loidolt/mostly-printed-cnc/README.md

# Mostly Printed CNC

Config and parts for the mostly printed cnc.

## Contributing
Pull requests are welcome. For major changes, please open an issue first to discuss what you would like to change.

Please make sure to update tests as appropriate.
