loidolt/mostly-printed-cnc/ModParts/Dewalt DW660 Mount/660_lower_main.stl

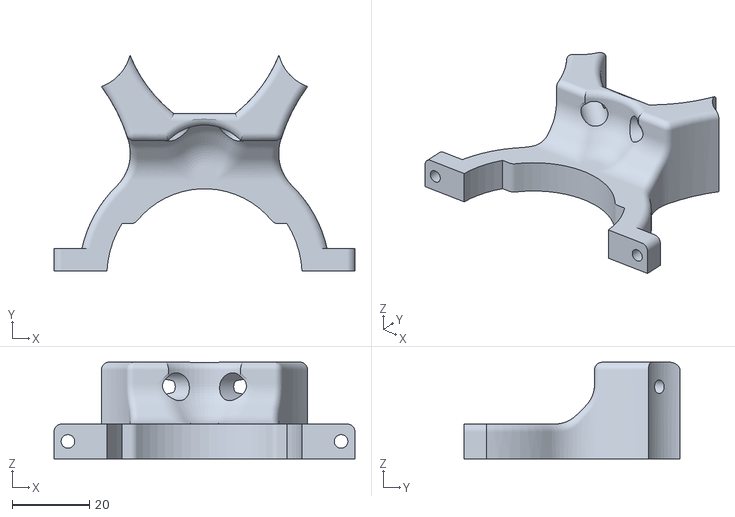
[picture p1: CAD file, 2019-04-01]
ModParts/Dewalt DW660 Mount/660_lower_main.stl
77.9 x 55.8 x 25.0
