loidolt/mostly-printed-cnc/ModParts/Dewalt DW660 Mount/660_upper_main.stl

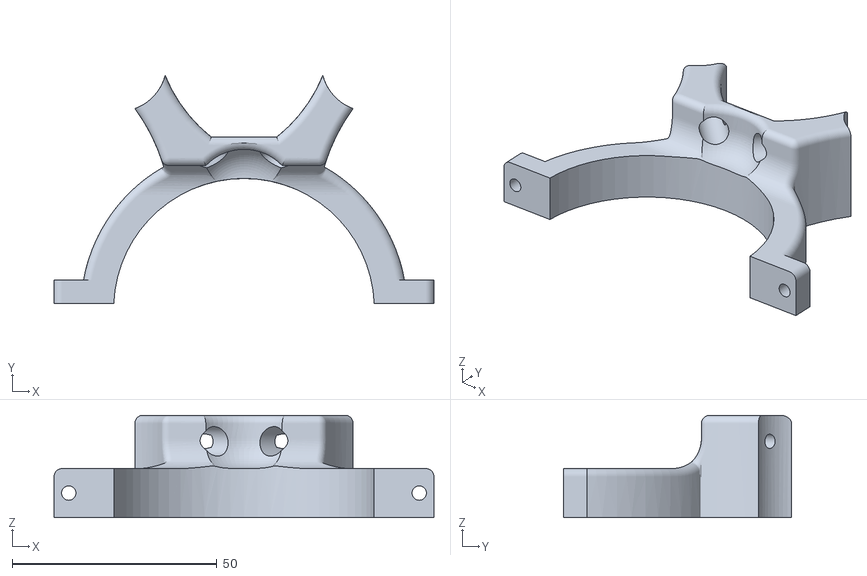
[picture p2: CAD file, 2019-04-01]
ModParts/Dewalt DW660 Mount/660_upper_main.stl
92.9 x 55.8 x 25.0
