loidolt/mostly-printed-cnc/Calibration/clampingHoles.dxf

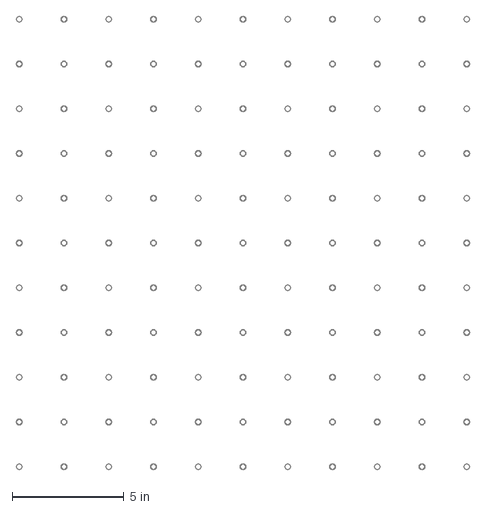
[picture p3: CAD file, 2019-04-01]
Calibration/clampingHoles.dxf
20.2 x 20.2 in
