loidolt/mostly-printed-cnc/ModParts/Cable Chain/cable_chain_plated.stl

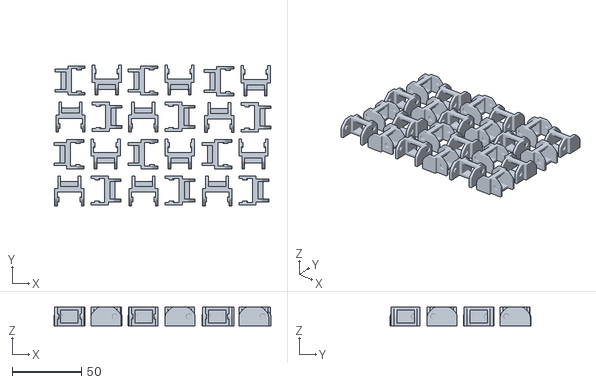
[picture p4: CAD file, 2019-04-01]
ModParts/Cable Chain/cable_chain_plated.stl
156.8 x 101.6 x 13.5
