loidolt/mostly-printed-cnc/ModParts/Drag knife/Blade_Cover.stl

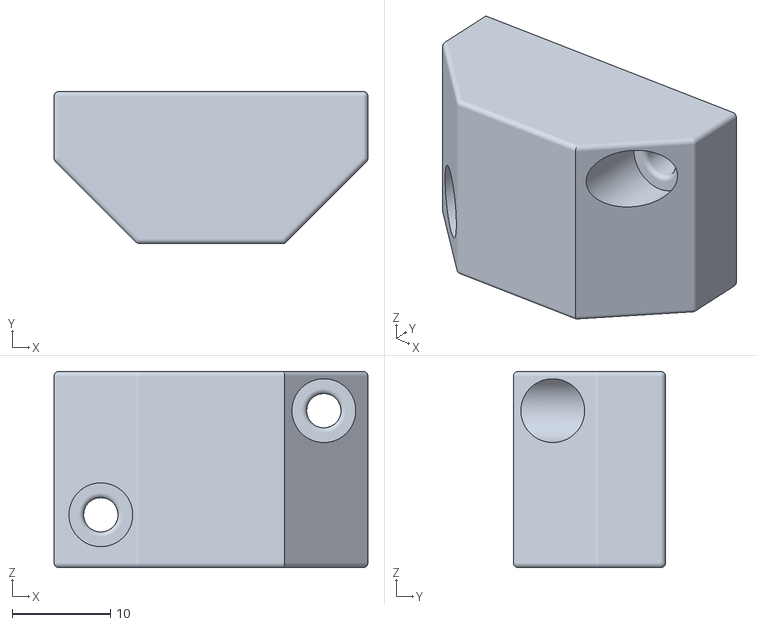
[picture p5: CAD file, 2019-04-01]
ModParts/Drag knife/Blade_Cover.stl
32.0 x 15.5 x 20.0
