loidolt/mostly-printed-cnc/ModParts/Electronics Case/standoff.stl

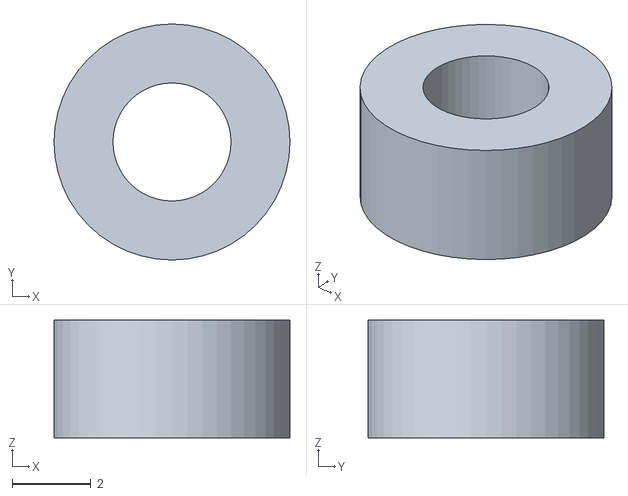
[picture p6: CAD file, 2019-04-01]
ModParts/Electronics Case/standoff.stl
6.00 x 6.00 x 3.00
