loidolt/mostly-printed-cnc/ModParts/EMT_Conduit_Caps/emtcapwireslotv2.STL

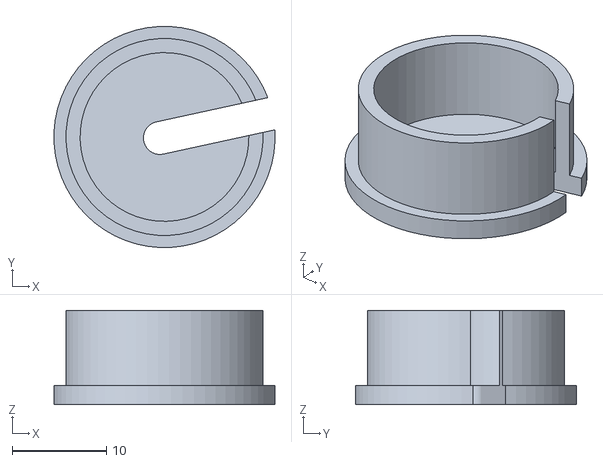
[picture p7: CAD file, 2019-04-01]
ModParts/EMT_Conduit_Caps/emtcapwireslotv2.STL
23.5 x 23.5 x 10.0
