loidolt/mostly-printed-cnc/ModParts/Feet/IE_Foot_Bottom.stl

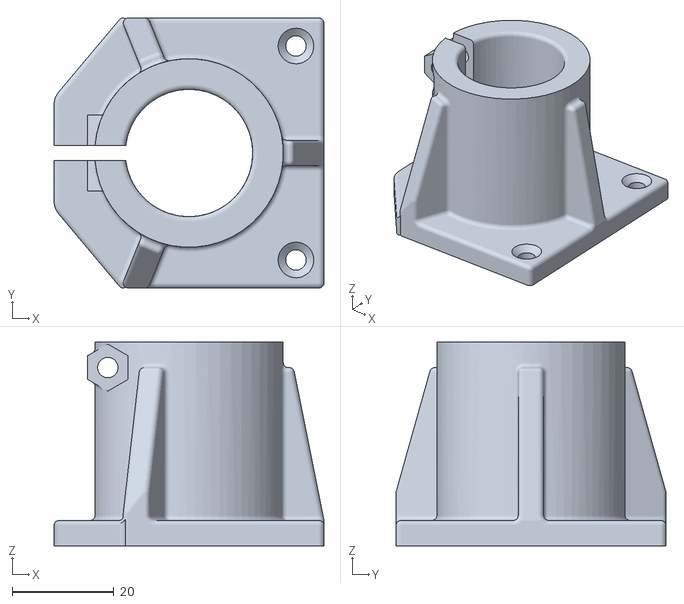
[picture p8: CAD file, 2019-04-01]
ModParts/Feet/IE_Foot_Bottom.stl
53.0 x 53.0 x 40.0
