loidolt/mostly-printed-cnc/ModParts/Modular Electronics Case/Designed/powerSwitchPanel.stl

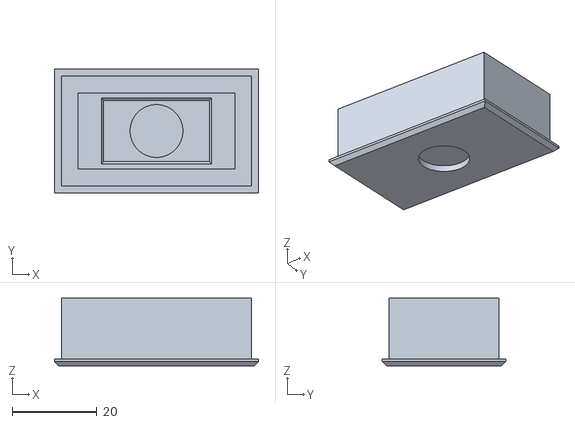
[picture p9: CAD file, 2019-04-01]
ModParts/Modular Electronics Case/Designed/powerSwitchPanel.stl
48.2 x 29.2 x 16.0
