loidolt/mostly-printed-cnc/ModParts/Modular Electronics Case/mm_ramps1dot4_pi_lower.stl

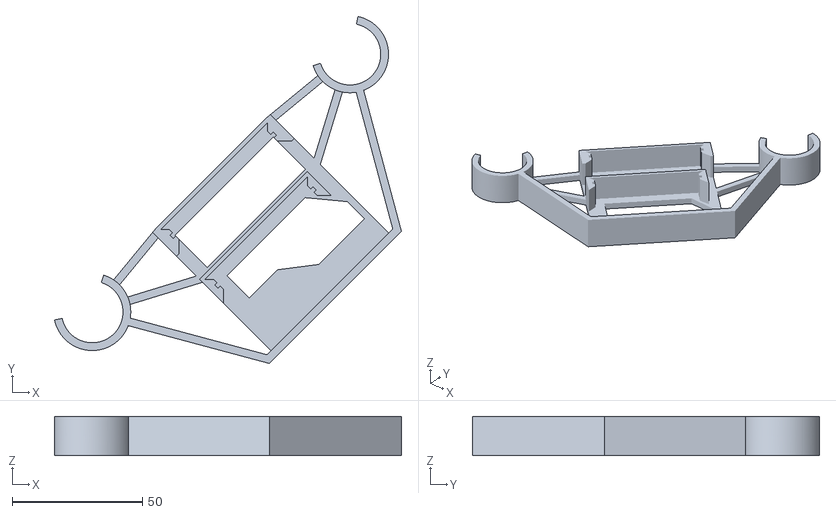
[picture p10: CAD file, 2019-04-01]
ModParts/Modular Electronics Case/mm_ramps1dot4_pi_lower.stl
133.3 x 133.3 x 15.0
