loidolt/mostly-printed-cnc/ModParts/Pen Mount/Tool_mount_insert.STL

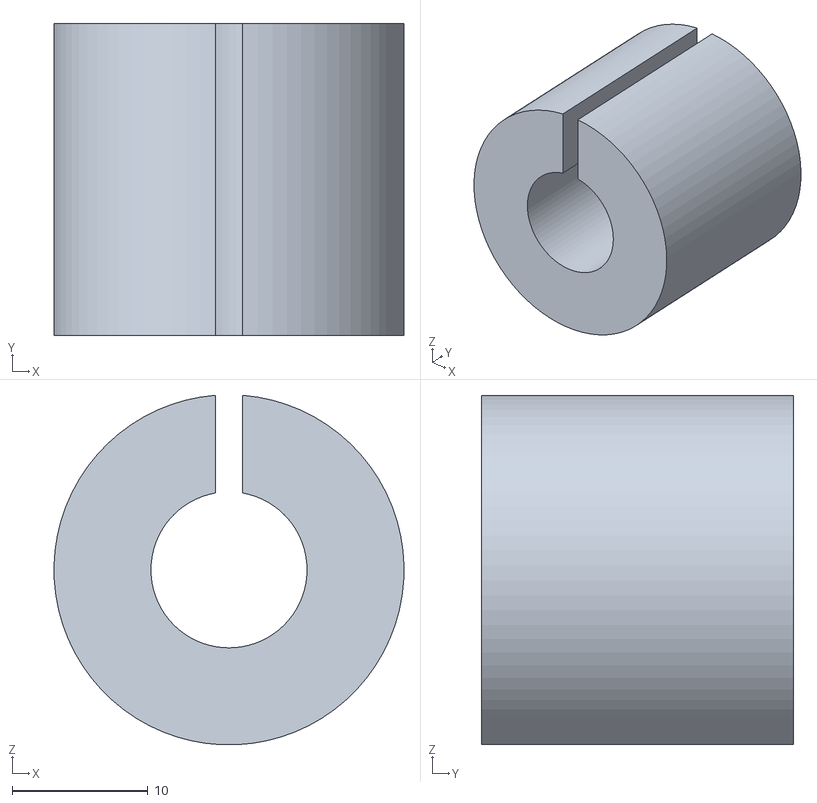
[picture p11: CAD file, 2019-04-01]
ModParts/Pen Mount/Tool_mount_insert.STL
25.8 x 23.0 x 25.7
