loidolt/mostly-printed-cnc/ModParts/RAMPs 1.4 Case/80mm_fan_adapter_case_for_arduino_mega_r3_and_ramps_14.stl

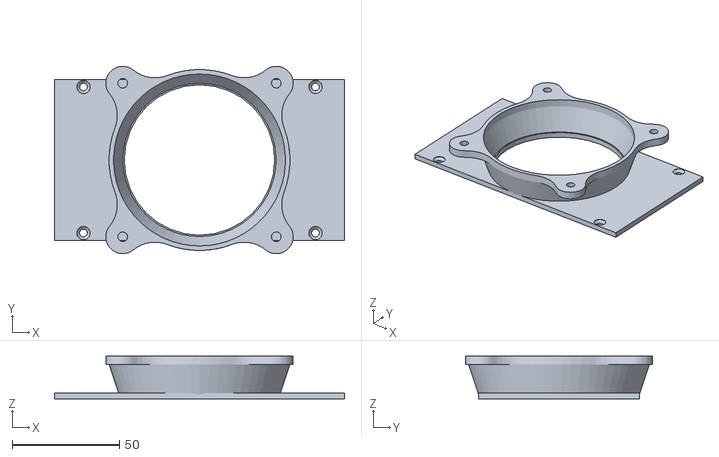
[picture p12: CAD file, 2019-04-01]
ModParts/RAMPs 1.4 Case/80mm_fan_adapter_case_for_arduino_mega_r3_and_ramps_14.stl
135.0 x 87.2 x 20.0
