loidolt/mostly-printed-cnc/ModParts/Ramps14SmartLCD/minion_body_bottom_remix_1.0.stl

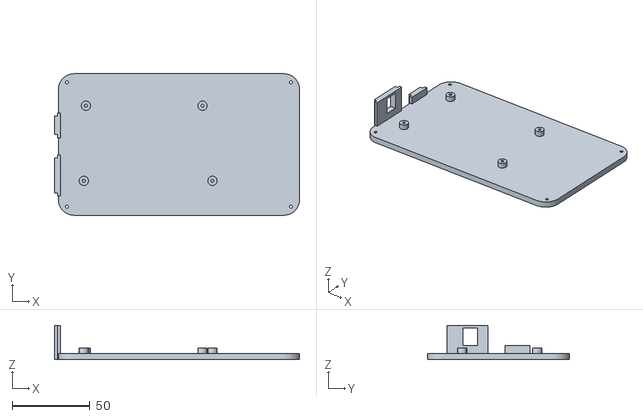
[picture p13: CAD file, 2019-04-01]
ModParts/Ramps14SmartLCD/minion_body_bottom_remix_1.0.stl
157.5 x 91.0 x 21.9
