loidolt/mostly-printed-cnc/ModParts/Sainsmart_12864_LCD_case/knob.stl

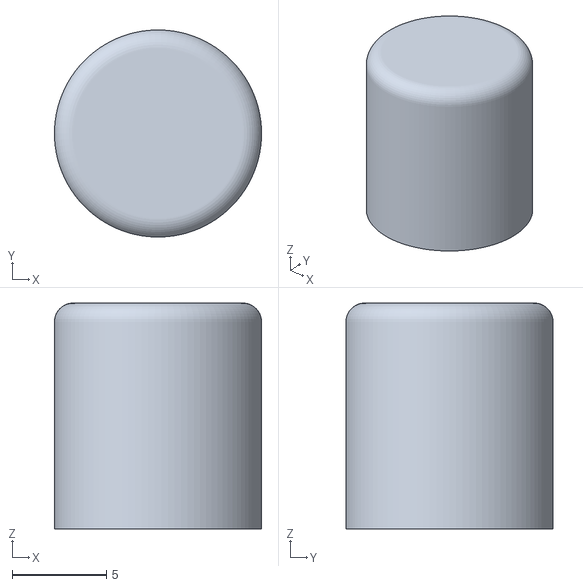
[picture p14: CAD file, 2019-04-01]
ModParts/Sainsmart_12864_LCD_case/knob.stl
11.0 x 11.0 x 12.0
