loidolt/mostly-printed-cnc/ModParts/solderless_Roller_Motor_Mount.STL

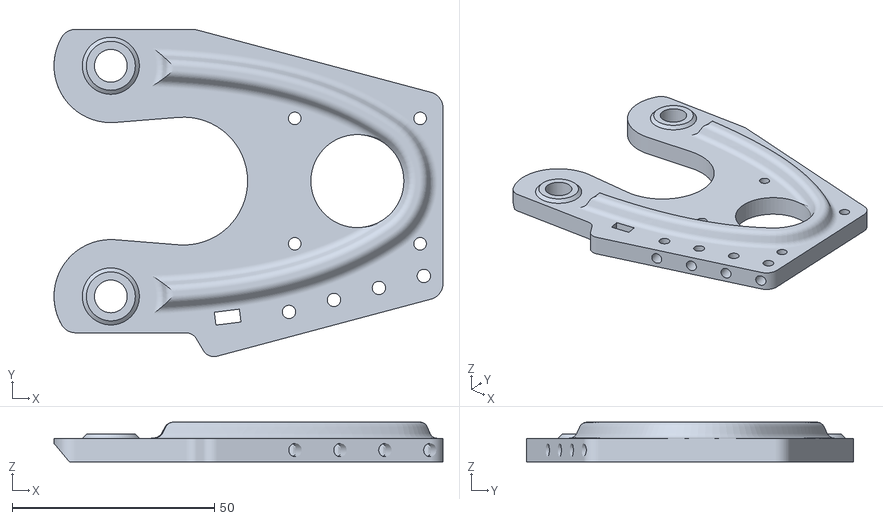
[picture p15: CAD file, 2019-04-01]
ModParts/solderless_Roller_Motor_Mount.STL
96.1 x 80.9 x 9.84
