loidolt/mostly-printed-cnc/ModParts/Square Check/MPCNC_Square_Check_Long_Side.stl

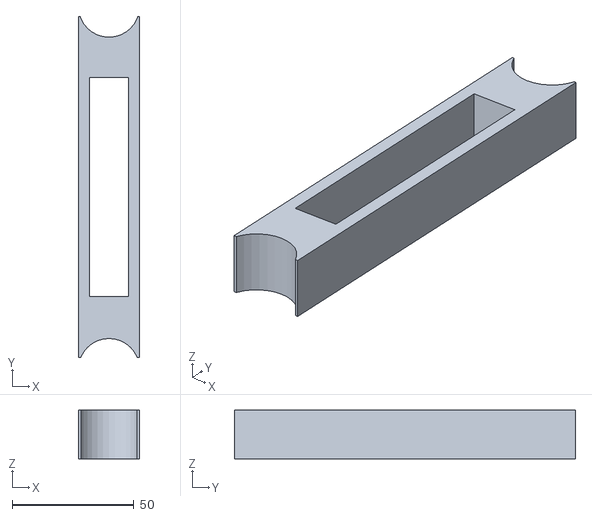
[picture p16: CAD file, 2019-04-01]
ModParts/Square Check/MPCNC_Square_Check_Long_Side.stl
25.0 x 140.0 x 20.0
