loidolt/mostly-printed-cnc/SettingsandProfiles/Marlin-Release/Documentation/Logo/Marlin Logo.dxf

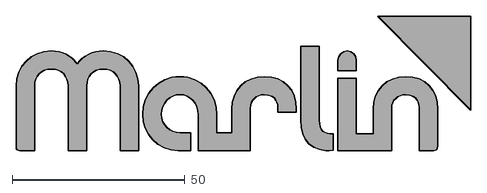
[picture p17: CAD file, 2019-04-01]
SettingsandProfiles/Marlin-Release/Documentation/Logo/Marlin Logo.dxf
131.6 x 39.5
