loidolt/mostly-printed-cnc/Calibration/ShapeOko_Calibration_Pattern_01b.dxf

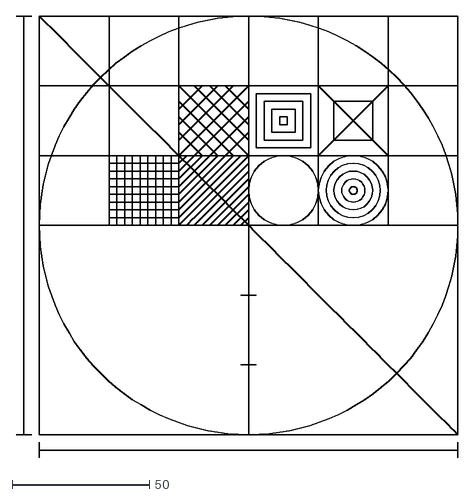
[picture p18: CAD file, 2019-04-01]
Calibration/ShapeOko_Calibration_Pattern_01b.dxf
160.9 x 160.9
