loidolt/mostly-printed-cnc/ModParts/Cable Chain/Chain_Guide_Brkt.stl

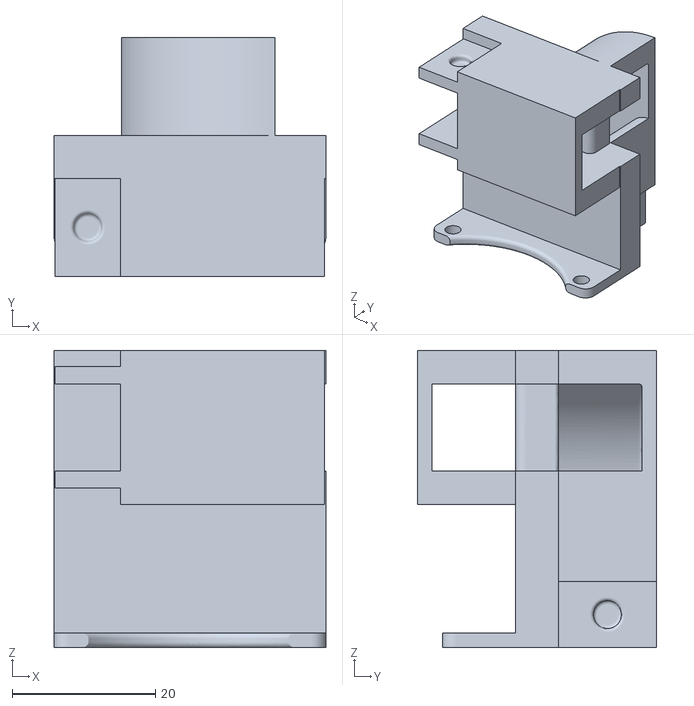
[picture p19: CAD file, 2019-04-01]
ModParts/Cable Chain/Chain_Guide_Brkt.stl
38.0 x 33.4 x 41.5
