loidolt/mostly-printed-cnc/ModParts/Dewalt DW660 Mount/660_lower_clamp.stl

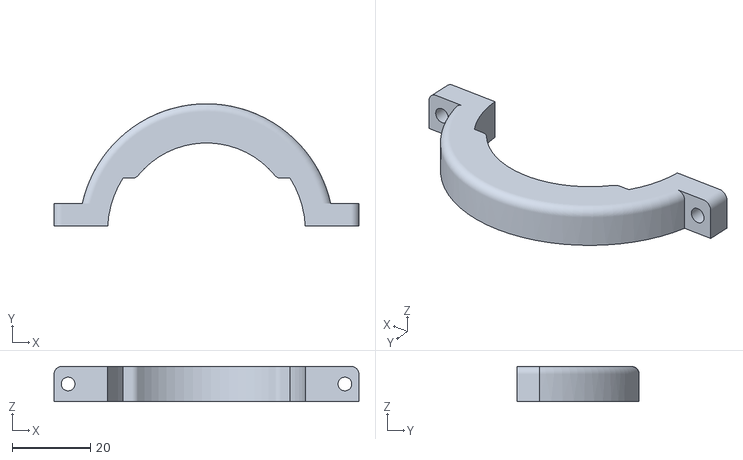
[picture p20: CAD file, 2019-04-01]
ModParts/Dewalt DW660 Mount/660_lower_clamp.stl
77.9 x 31.2 x 9.00
