loidolt/mostly-printed-cnc/ModParts/Drag knife/P3.stl

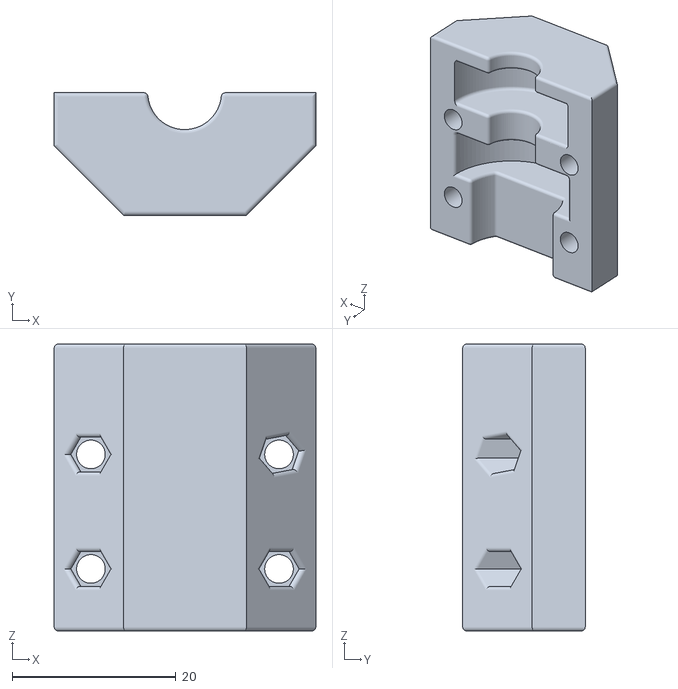
[picture p21: CAD file, 2019-04-01]
ModParts/Drag knife/P3.stl
32.0 x 15.0 x 35.1
