loidolt/mostly-printed-cnc/ModParts/Electronics Case/electronicsCaseBack.stl

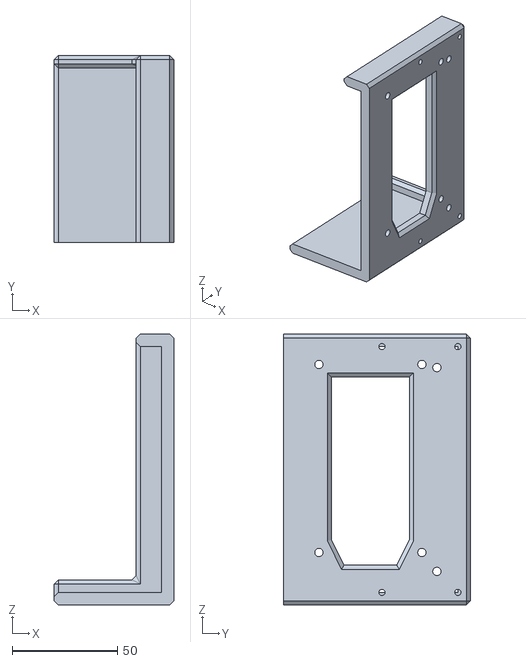
[picture p22: CAD file, 2019-04-01]
ModParts/Electronics Case/electronicsCaseBack.stl
57.0 x 89.0 x 129.0
