loidolt/mostly-printed-cnc/ModParts/EMT_Conduit_Caps/emtcapv2.STL

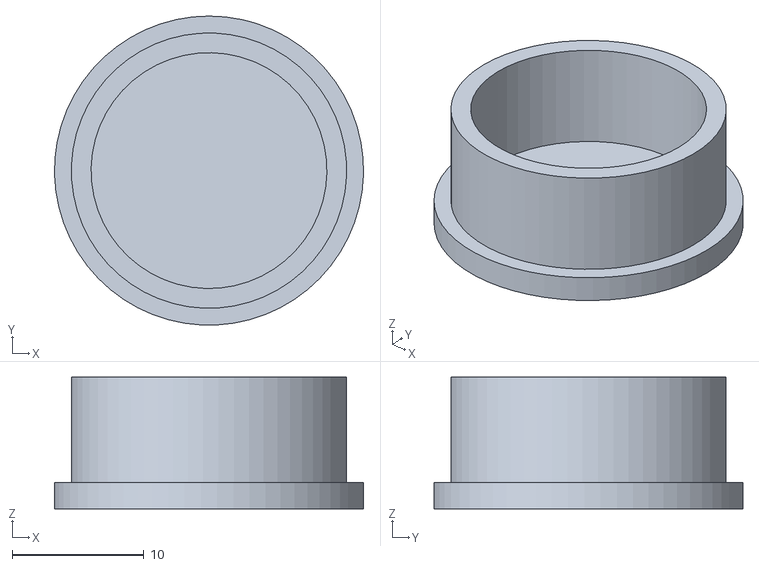
[picture p23: CAD file, 2019-04-01]
ModParts/EMT_Conduit_Caps/emtcapv2.STL
23.5 x 23.5 x 10.0
