loidolt/mostly-printed-cnc/ModParts/Middle_Z_rigid.STL

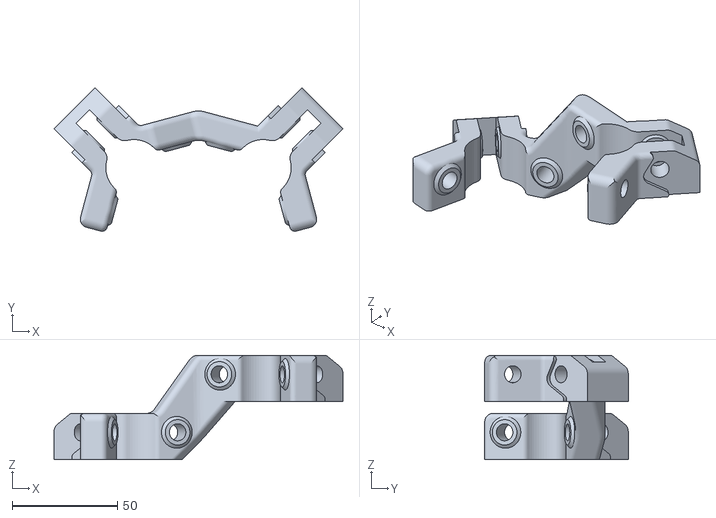
[picture p25: CAD file, 2019-04-01]
ModParts/Middle_Z_rigid.STL
137.4 x 68.3 x 49.6
