loidolt/mostly-printed-cnc/ModParts/RAMPs 1.4 Case/Left_side.stl

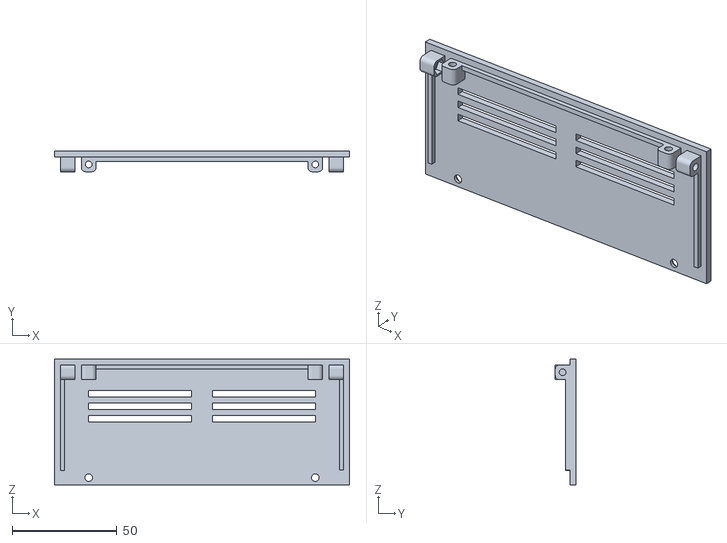
[picture p27: CAD file, 2019-04-01]
ModParts/RAMPs 1.4 Case/Left_side.stl
140.6 x 9.80 x 60.0
