loidolt/mostly-printed-cnc/ModParts/Ramps14SmartLCD/minion_base_hinge_remix_1.0.stl

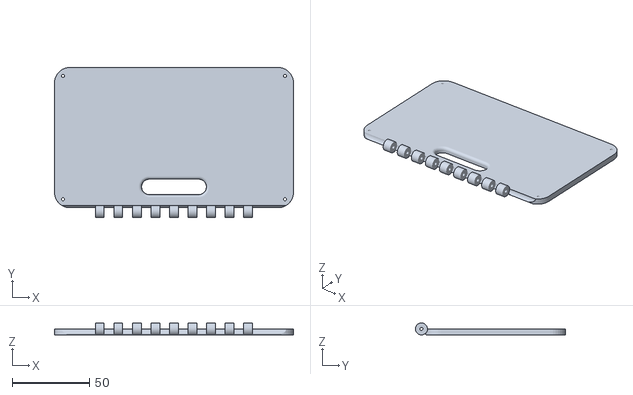
[picture p28: CAD file, 2019-04-01]
ModParts/Ramps14SmartLCD/minion_base_hinge_remix_1.0.stl
155.0 x 97.4 x 7.90
