loidolt/mostly-printed-cnc/ModParts/Sainsmart_12864_LCD_case/Button.stl

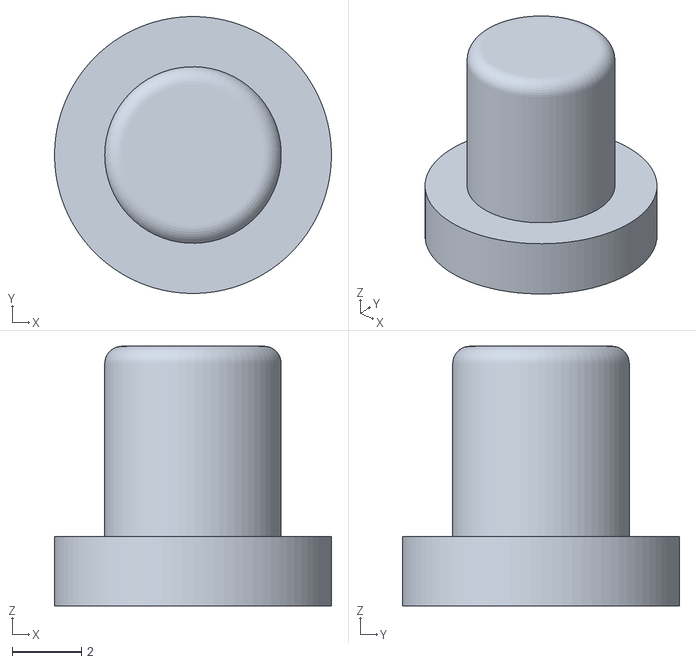
[picture p29: CAD file, 2019-04-01]
ModParts/Sainsmart_12864_LCD_case/Button.stl
8.00 x 8.00 x 7.50
