loidolt/mostly-printed-cnc/ModParts/Square Check/MPCNC_Square_Check_Short_Side.stl

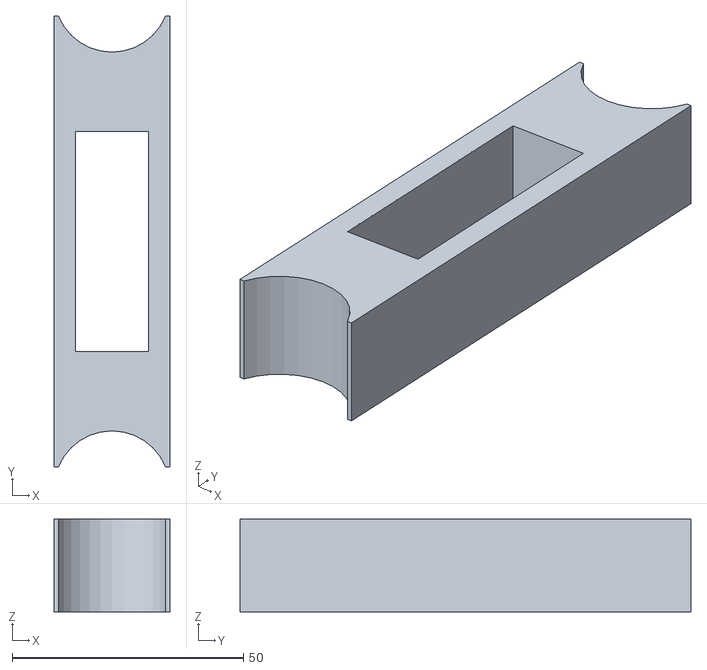
[picture p30: CAD file, 2019-04-01]
ModParts/Square Check/MPCNC_Square_Check_Short_Side.stl
25.0 x 97.5 x 20.0
