loidolt/mostly-printed-cnc/Stock Parts/Middle_Joiner.STL

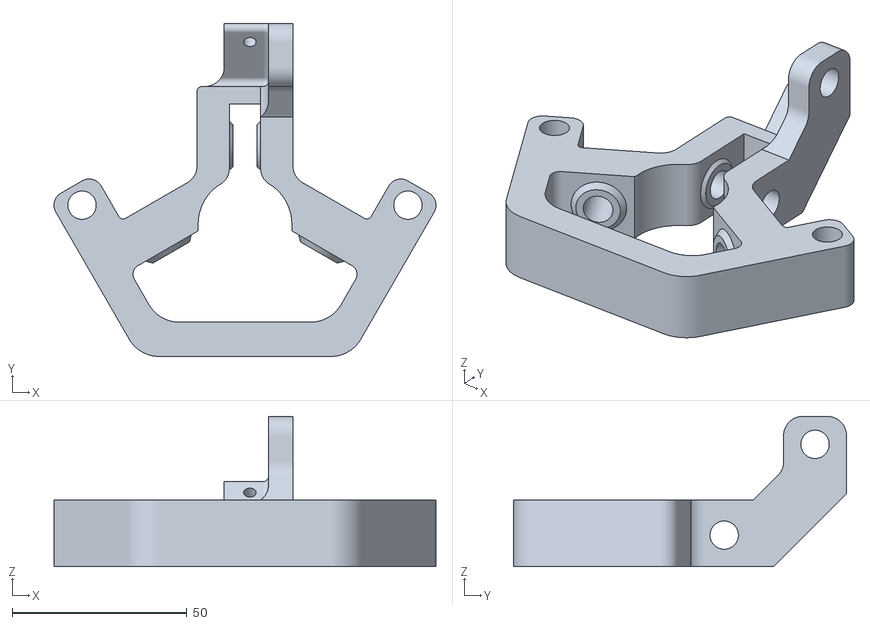
[picture p31: CAD file, 2019-04-01]
Stock Parts/Middle_Joiner.STL
109.4 x 95.3 x 43.0
