loidolt/mostly-printed-cnc/ModParts/Cable Chain/Chain_Guide_Hold_Down.stl

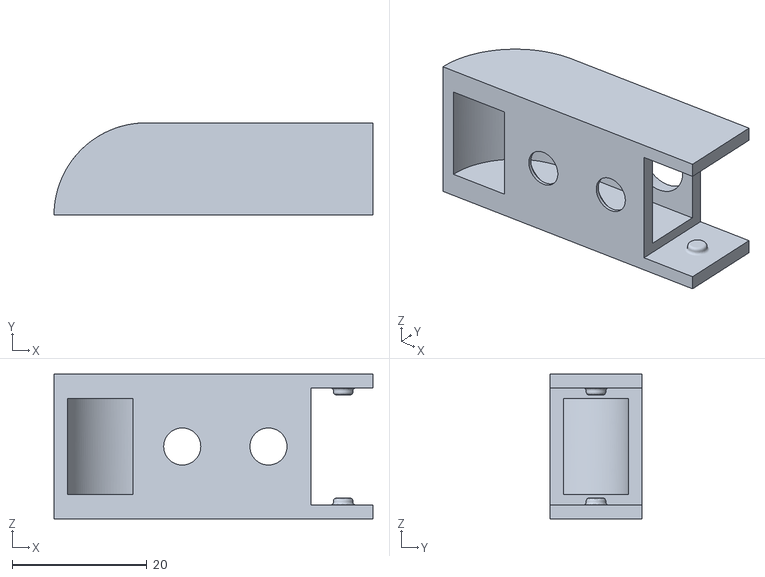
[picture p32: CAD file, 2019-04-01]
ModParts/Cable Chain/Chain_Guide_Hold_Down.stl
47.3 x 13.7 x 21.5
