loidolt/mostly-printed-cnc/ModParts/Drag knife/P2.stl

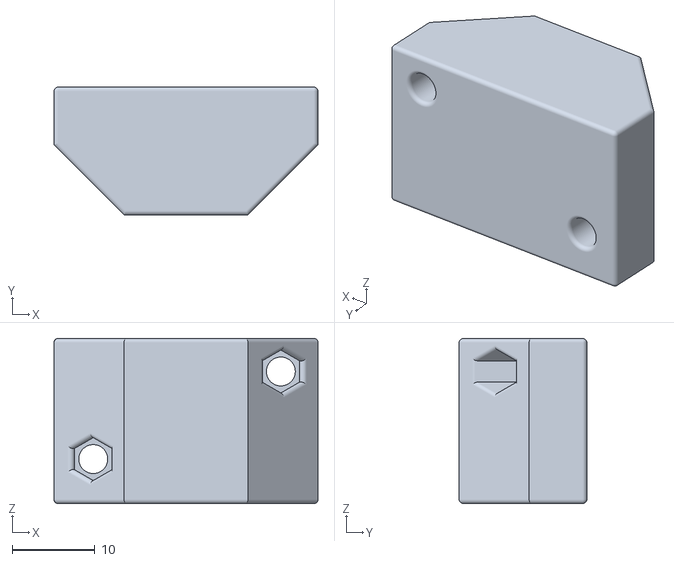
[picture p33: CAD file, 2019-04-01]
ModParts/Drag knife/P2.stl
32.0 x 15.5 x 20.0
