loidolt/mostly-printed-cnc/ModParts/Electronics Case/electronicsCaseFront.stl

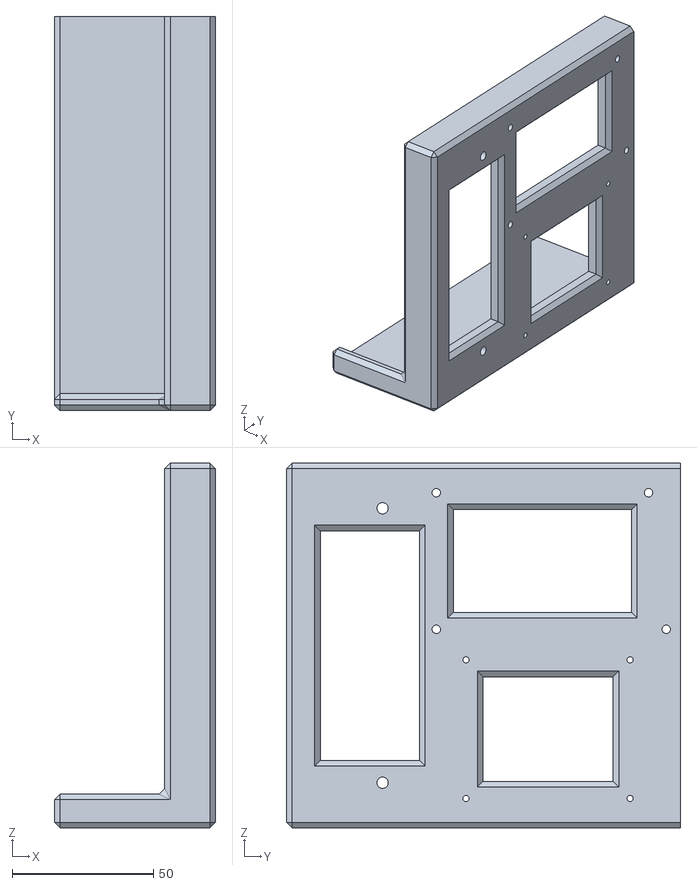
[picture p34: CAD file, 2019-04-01]
ModParts/Electronics Case/electronicsCaseFront.stl
57.0 x 139.4 x 129.0
