loidolt/mostly-printed-cnc/ModParts/Feet/IE-Flex_Foot.STL

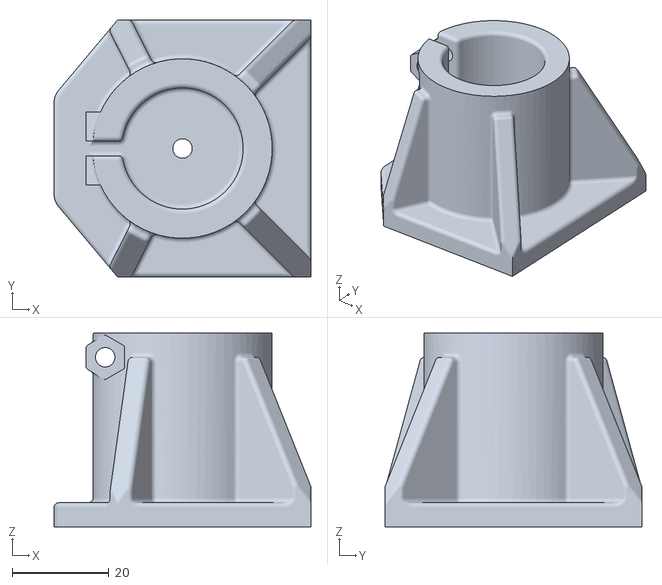
[picture p35: CAD file, 2019-04-01]
ModParts/Feet/IE-Flex_Foot.STL
53.0 x 53.0 x 40.0
