loidolt/mostly-printed-cnc/ModParts/RAMPs 1.4 Case/Front_side.stl

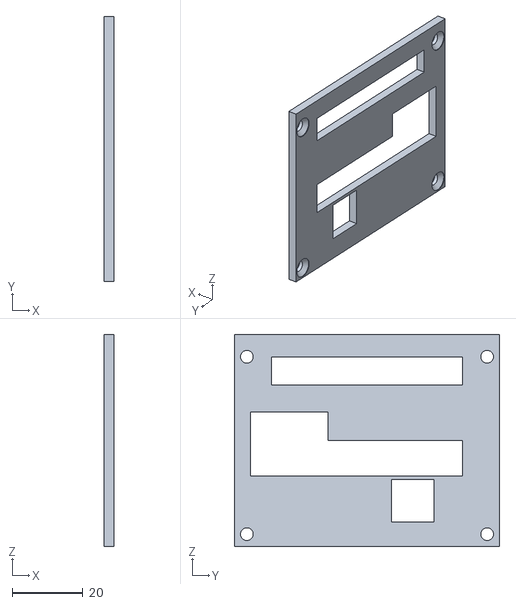
[picture p37: CAD file, 2019-04-01]
ModParts/RAMPs 1.4 Case/Front_side.stl
2.80 x 75.0 x 60.0
