loidolt/mostly-printed-cnc/ModParts/Sainsmart_12864_LCD_case/Top.stl

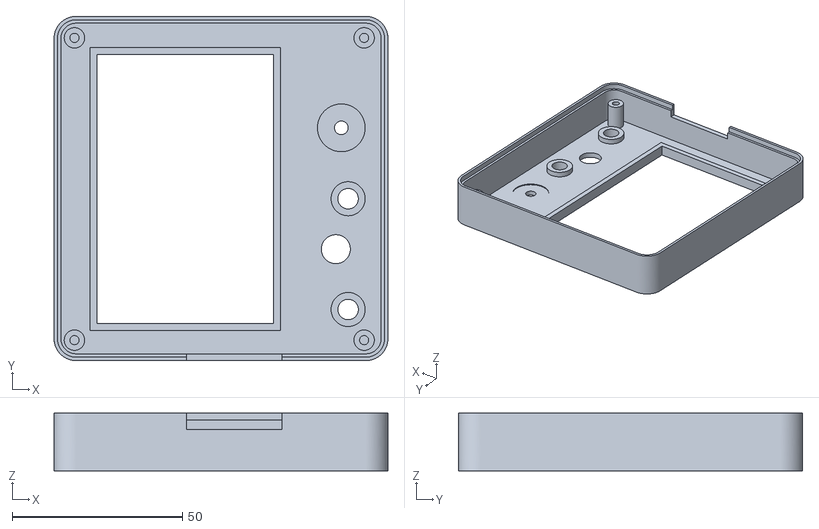
[picture p38: CAD file, 2019-04-01]
ModParts/Sainsmart_12864_LCD_case/Top.stl
98.0 x 101.0 x 17.0
