loidolt/mostly-printed-cnc/ModParts/Z_Knob.STL

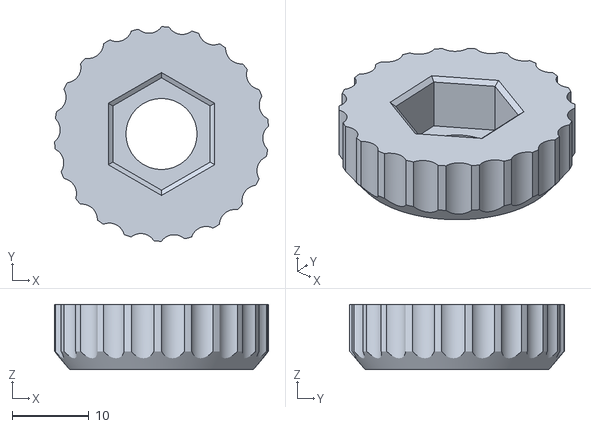
[picture p39: CAD file, 2019-04-01]
ModParts/Z_Knob.STL
27.9 x 28.0 x 8.50
