loidolt/mostly-printed-cnc/ModParts/Cable Chain/Chain_Guide_hold_down_External_Bracket.stl

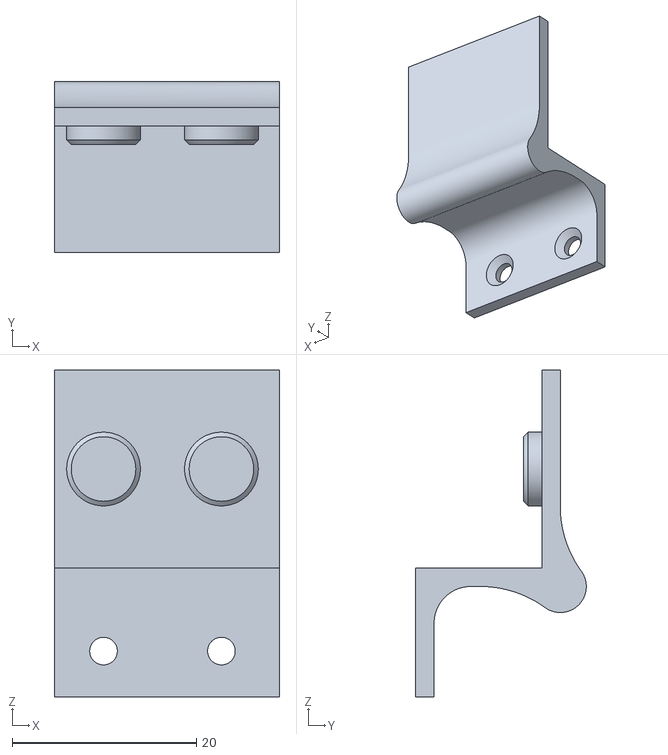
[picture p40: CAD file, 2019-04-01]
ModParts/Cable Chain/Chain_Guide_hold_down_External_Bracket.stl
24.4 x 18.5 x 35.5
