loidolt/mostly-printed-cnc/ModParts/Dewalt DW660 Mount/660_upper_clamp.stl

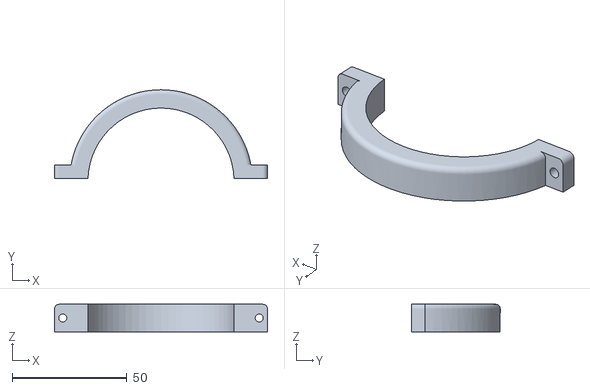
[picture p41: CAD file, 2019-04-01]
ModParts/Dewalt DW660 Mount/660_upper_clamp.stl
92.9 x 38.6 x 12.0
