loidolt/mostly-printed-cnc/ModParts/Modular Electronics Case/RAMPS_Fan_Mount.stl

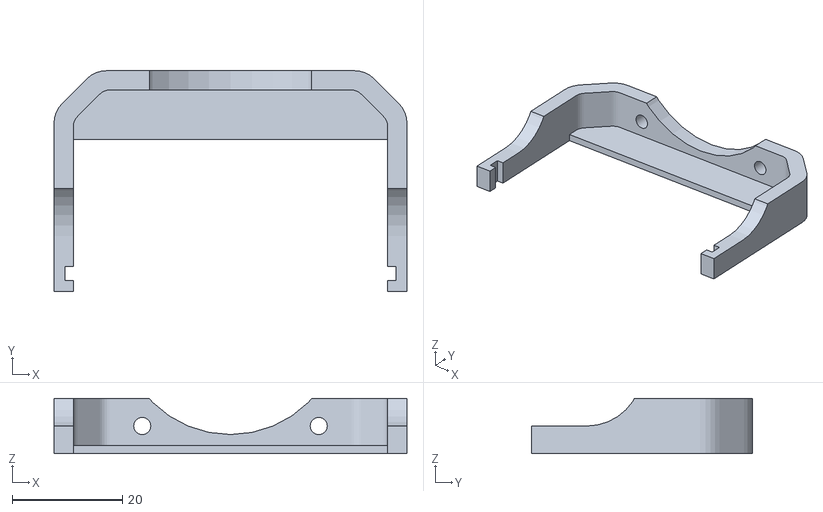
[picture p42: CAD file, 2019-04-01]
ModParts/Modular Electronics Case/RAMPS_Fan_Mount.stl
64.0 x 40.0 x 10.0
