loidolt/mostly-printed-cnc/ModParts/Ramps14SmartLCD/minion_body_remix_1.0.stl

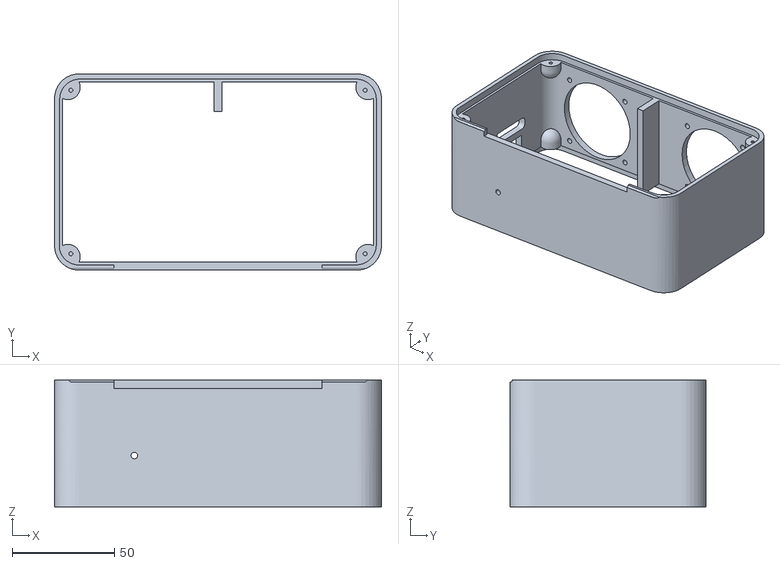
[picture p43: CAD file, 2019-04-01]
ModParts/Ramps14SmartLCD/minion_body_remix_1.0.stl
160.0 x 96.0 x 62.0
