loidolt/mostly-printed-cnc/ModParts/Sainsmart_12864_LCD_case/Bottom.stl

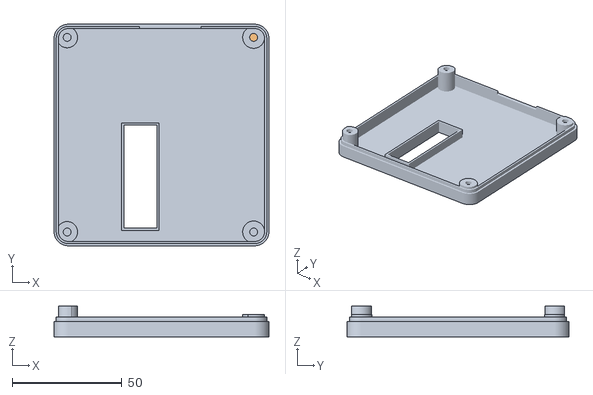
[picture p44: CAD file, 2019-04-01]
ModParts/Sainsmart_12864_LCD_case/Bottom.stl
98.0 x 101.0 x 14.0
