loidolt/mostly-printed-cnc/ModParts/z_motor_mount_10mm_longer.STL

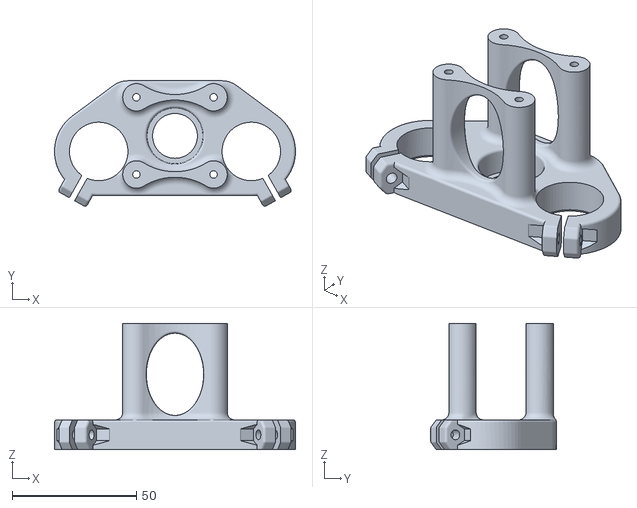
[picture p45: CAD file, 2019-04-01]
ModParts/z_motor_mount_10mm_longer.STL
96.8 x 50.4 x 50.8
