loidolt/mostly-printed-cnc/Stock Parts/Tool_Holder_13mm.STL

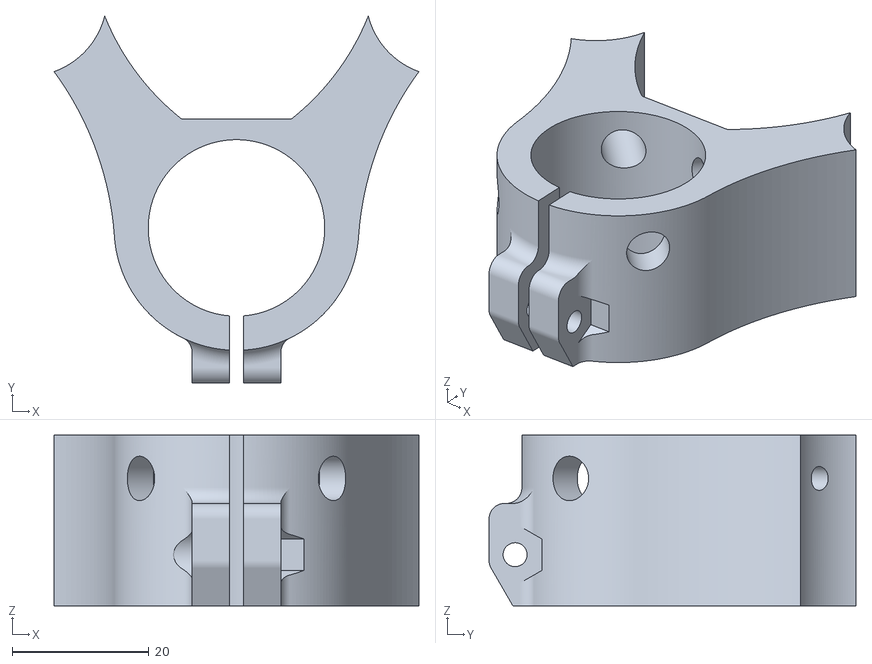
[picture p46: CAD file, 2019-04-01]
Stock Parts/Tool_Holder_13mm.STL
53.3 x 53.7 x 25.0
