loidolt/mostly-printed-cnc/ModParts/Cable Chain/Chain_Guide_holder_Top_Z.stl

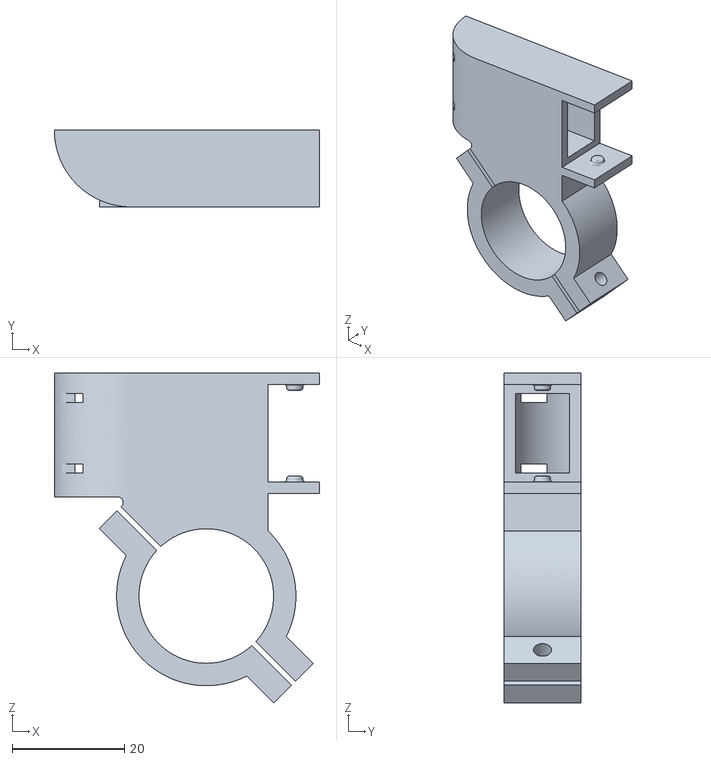
[picture p47: CAD file, 2019-04-01]
ModParts/Cable Chain/Chain_Guide_holder_Top_Z.stl
47.3 x 13.7 x 58.9
