loidolt/mostly-printed-cnc/ModParts/RAMPs 1.4 Case/Bottom_side.stl

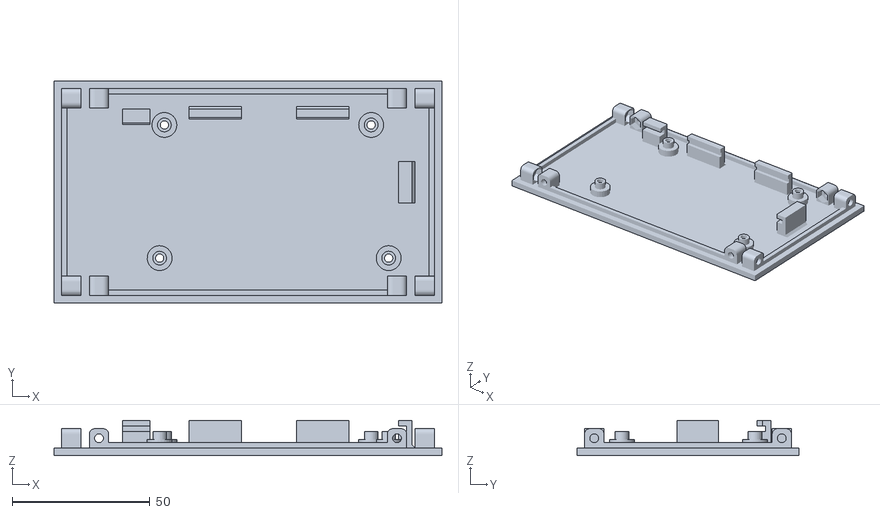
[picture p49: CAD file, 2019-04-01]
ModParts/RAMPs 1.4 Case/Bottom_side.stl
140.6 x 80.6 x 12.8
