loidolt/mostly-printed-cnc/ModParts/Ramps14SmartLCD/minion_remix_lcd_4mm_deeper.stl

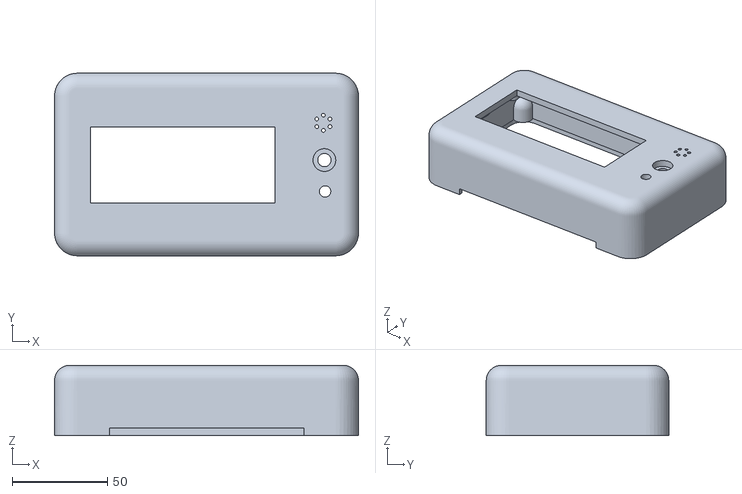
[picture p50: CAD file, 2019-04-01]
ModParts/Ramps14SmartLCD/minion_remix_lcd_4mm_deeper.stl
159.9 x 96.0 x 37.0
