loidolt/mostly-printed-cnc/Stock Parts/roller_lock.STL

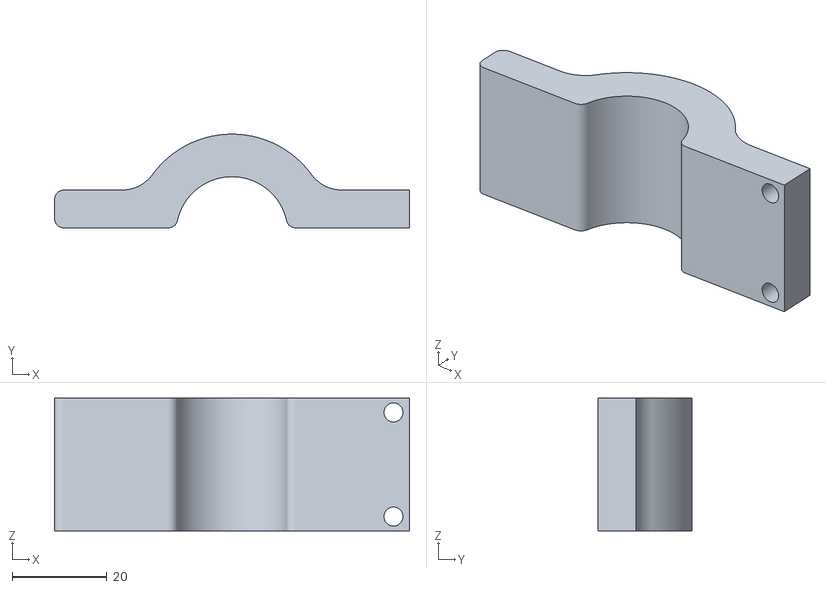
[picture p51: CAD file, 2019-04-01]
Stock Parts/roller_lock.STL
75.0 x 19.8 x 28.0
