loidolt/mostly-printed-cnc/ModParts/Cable Chain/Chain_Guide_Brkt_B.stl

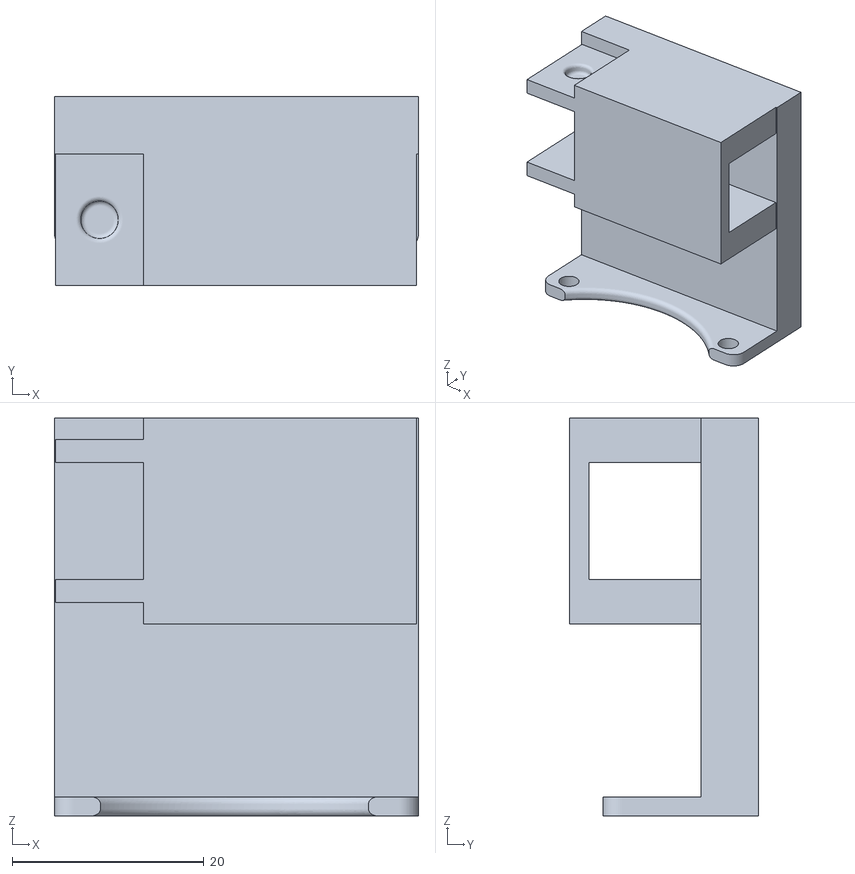
[picture p52: CAD file, 2019-04-01]
ModParts/Cable Chain/Chain_Guide_Brkt_B.stl
38.0 x 19.7 x 41.5
