loidolt/mostly-printed-cnc/ModParts/RAMPs 1.4 Case/Back_side_v2.stl

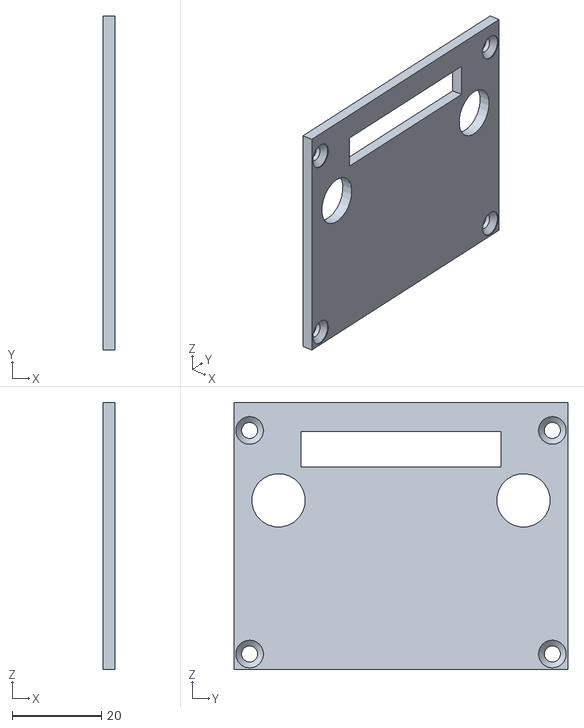
[picture p54: CAD file, 2019-04-01]
ModParts/RAMPs 1.4 Case/Back_side_v2.stl
2.80 x 75.0 x 60.0
