loidolt/mostly-printed-cnc/ModParts/Cable Chain/Chain_Guide_Brkt_Far_End.stl

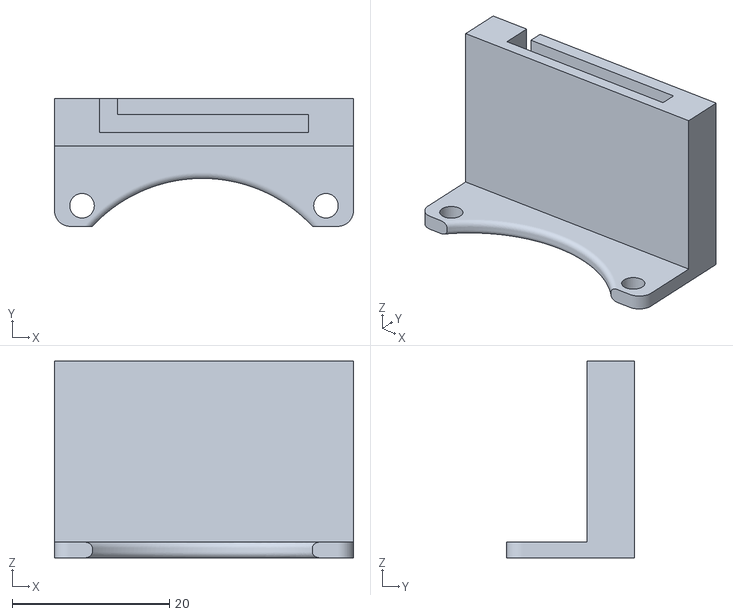
[picture p55: CAD file, 2019-04-01]
ModParts/Cable Chain/Chain_Guide_Brkt_Far_End.stl
38.0 x 16.2 x 25.0
