loidolt/mostly-printed-cnc/ModParts/Modular Electronics Case/mm_pi_upper.stl

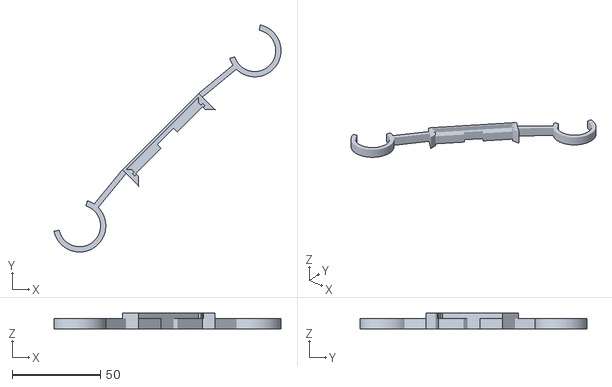
[picture p56: CAD file, 2019-04-01]
ModParts/Modular Electronics Case/mm_pi_upper.stl
128.3 x 128.3 x 9.00
