loidolt/mostly-printed-cnc/ModParts/RAMPs 1.4 Case/Right_side_reset.stl

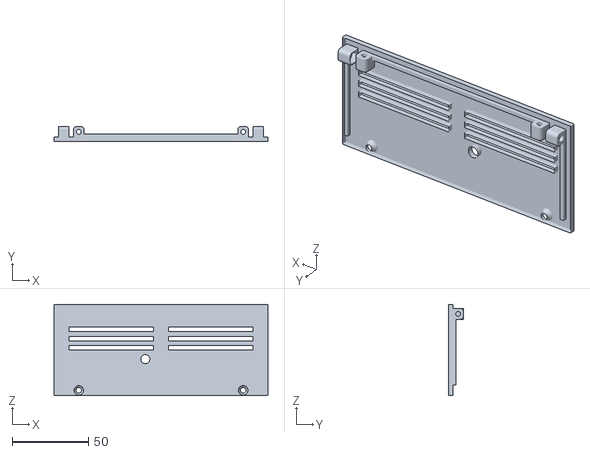
[picture p57: CAD file, 2019-04-01]
ModParts/RAMPs 1.4 Case/Right_side_reset.stl
140.6 x 9.80 x 60.0
