loidolt/mostly-printed-cnc/Stock Parts/Middle_Z.STL

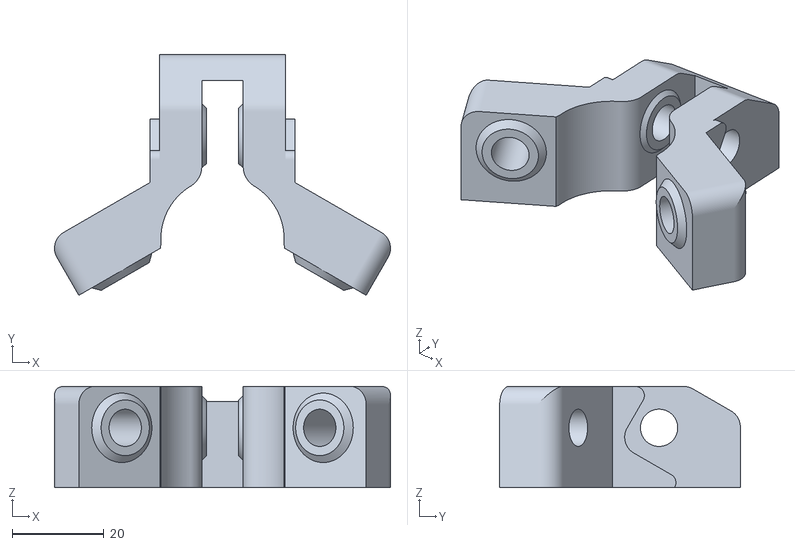
[picture p58: CAD file, 2019-04-01]
Stock Parts/Middle_Z.STL
73.1 x 52.3 x 22.0
