loidolt/mostly-printed-cnc/ModParts/Cable Chain/cable_chain_single.stl

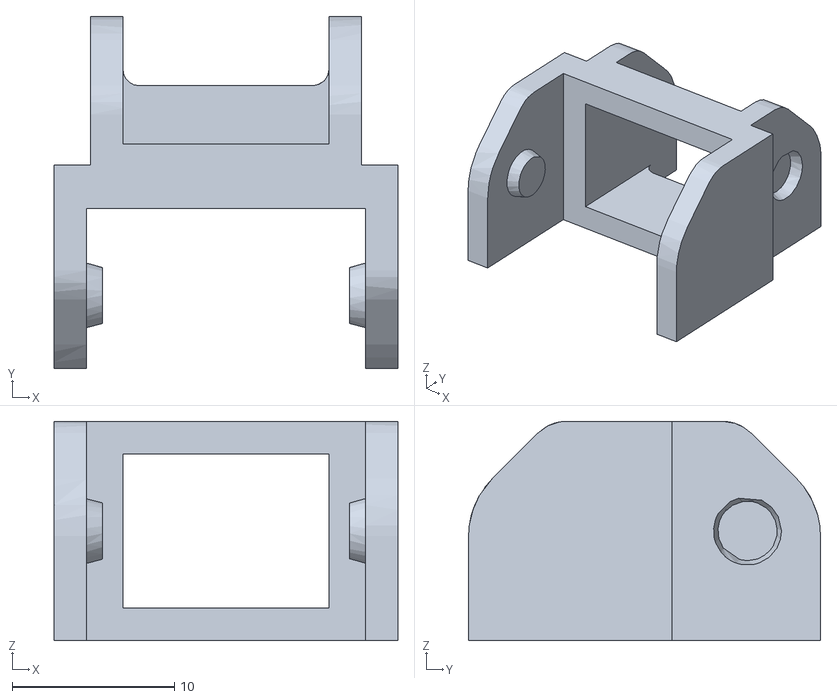
[picture p59: CAD file, 2019-04-01]
ModParts/Cable Chain/cable_chain_single.stl
21.2 x 21.7 x 13.5
