loidolt/mostly-printed-cnc/ModParts/Modular Electronics Case/mm_2dot8w_laser_driver.stl

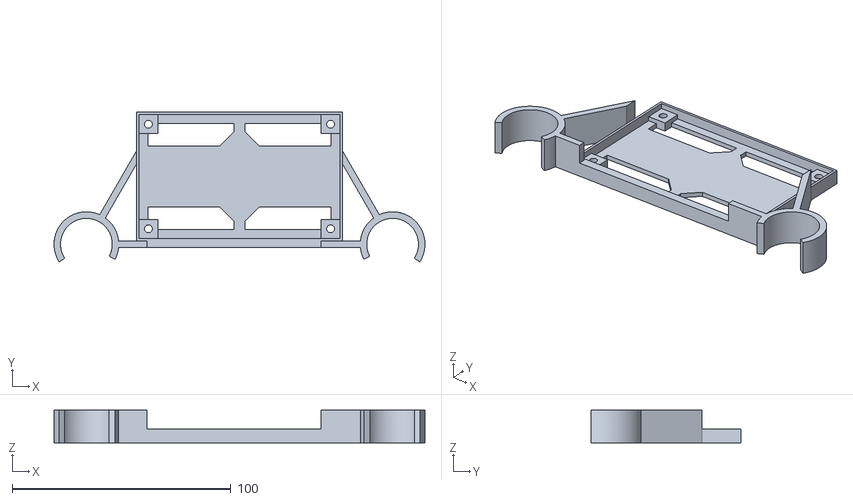
[picture p60: CAD file, 2019-04-01]
ModParts/Modular Electronics Case/mm_2dot8w_laser_driver.stl
169.6 x 68.5 x 15.0
