loidolt/mostly-printed-cnc/Stock Parts/Corner_Block_Lock.STL

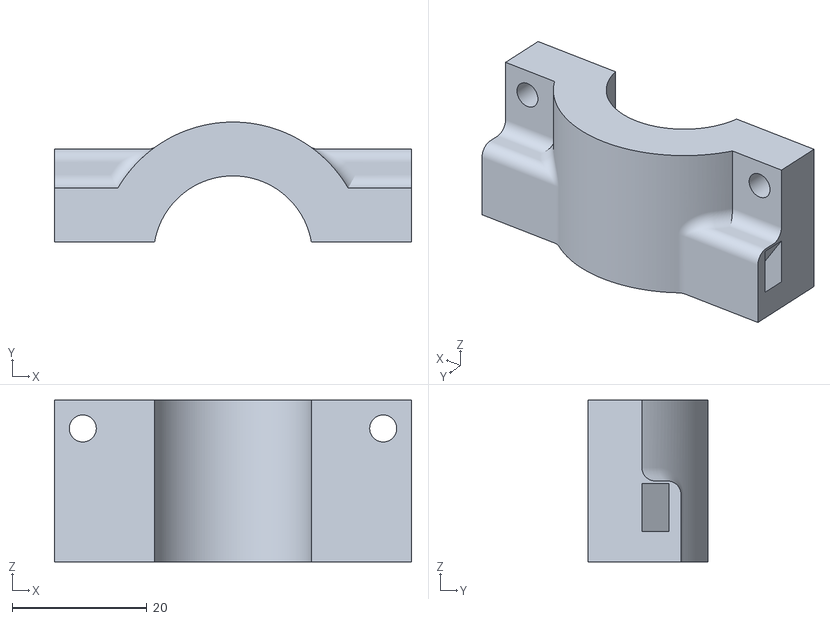
[picture p61: CAD file, 2019-04-01]
Stock Parts/Corner_Block_Lock.STL
53.0 x 17.8 x 24.0
