loidolt/mostly-printed-cnc/ModParts/Modular Electronics Case/mm_emt_locks_end.stl

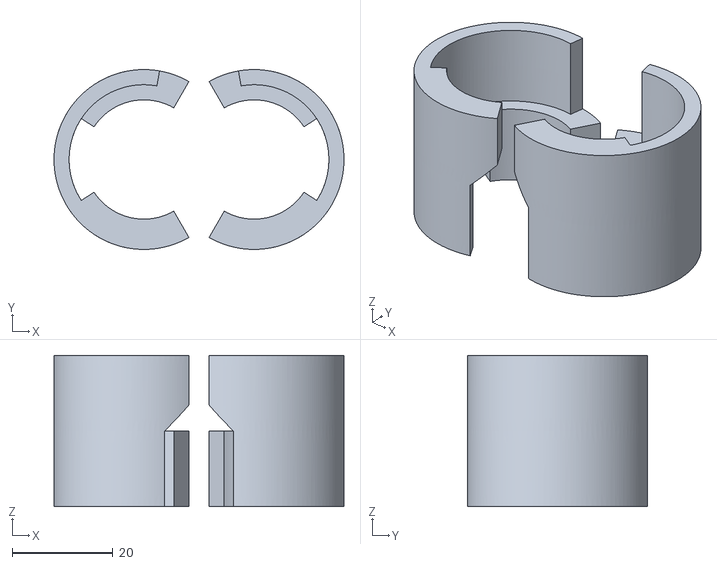
[picture p62: CAD file, 2019-04-01]
ModParts/Modular Electronics Case/mm_emt_locks_end.stl
57.4 x 35.6 x 30.0
