loidolt/mostly-printed-cnc/Stock Parts/Corner_Block.STL

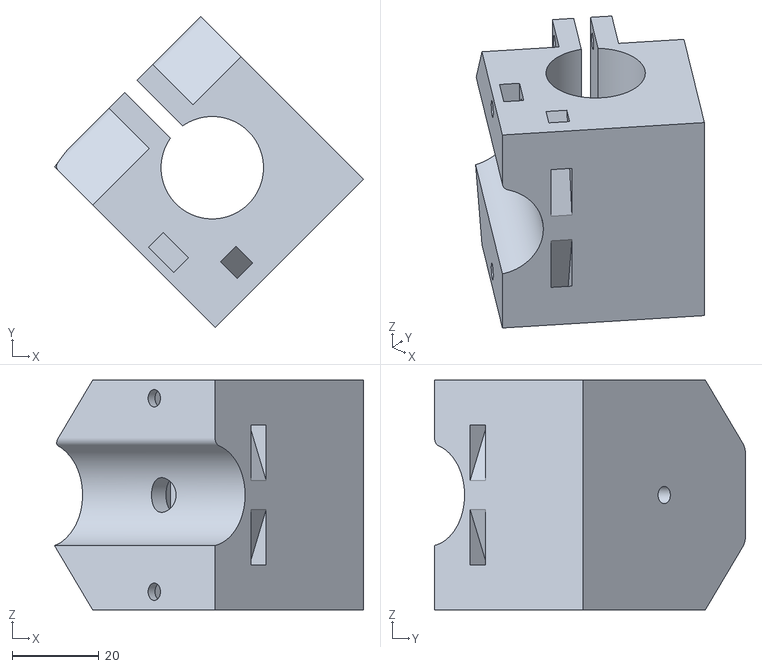
[picture p63: CAD file, 2019-04-01]
Stock Parts/Corner_Block.STL
71.2 x 71.7 x 53.0
