loidolt/mostly-printed-cnc/ModParts/Modular Electronics Case/mm_ps_40x100x165_lower.stl

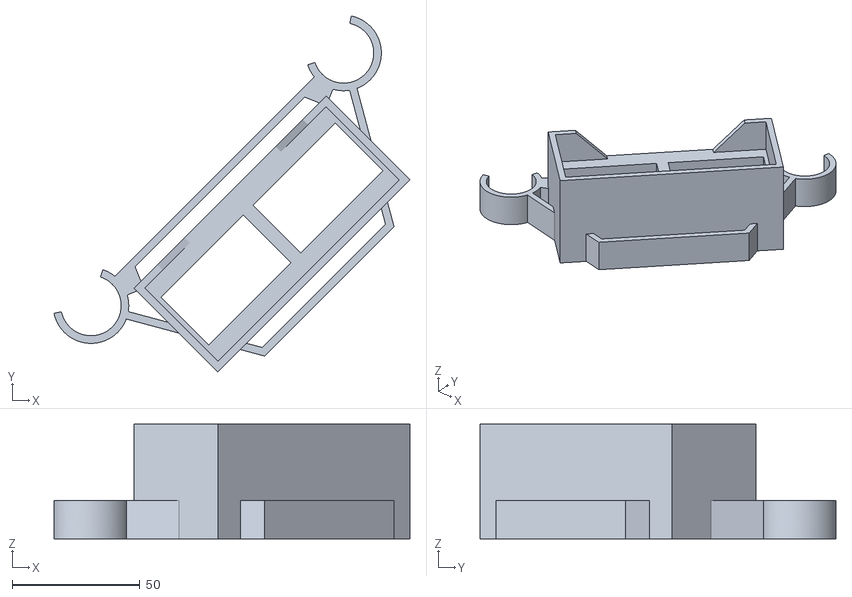
[picture p64: CAD file, 2019-04-01]
ModParts/Modular Electronics Case/mm_ps_40x100x165_lower.stl
139.5 x 139.5 x 45.0
