loidolt/mostly-printed-cnc/Stock Parts/Roller_Motor_Mount.STL

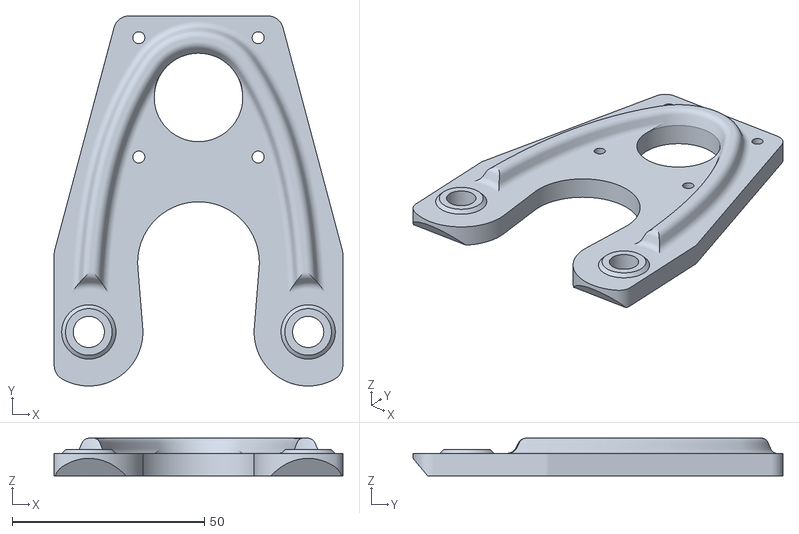
[picture p65: CAD file, 2019-04-01]
Stock Parts/Roller_Motor_Mount.STL
75.0 x 96.1 x 9.84
