loidolt/mostly-printed-cnc/ModParts/Modular Electronics Case/mm_va_meters.stl

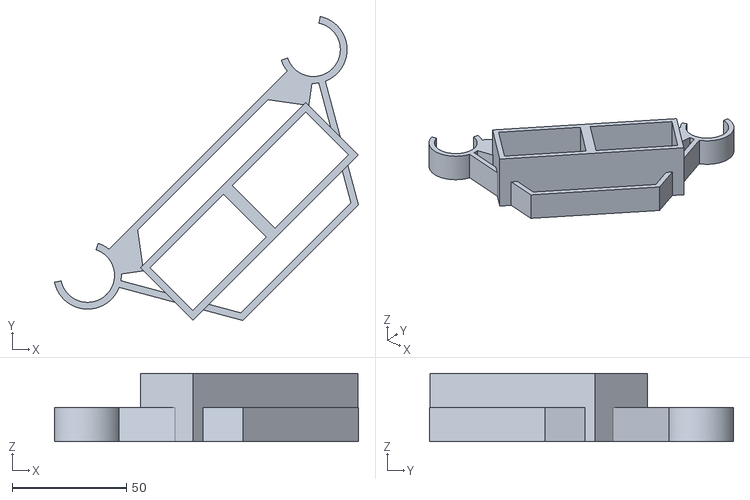
[picture p66: CAD file, 2019-04-01]
ModParts/Modular Electronics Case/mm_va_meters.stl
133.3 x 133.3 x 30.0
