loidolt/mostly-printed-cnc/Stock Parts/Rigid_Coupler_5_16_to_5mm.STL

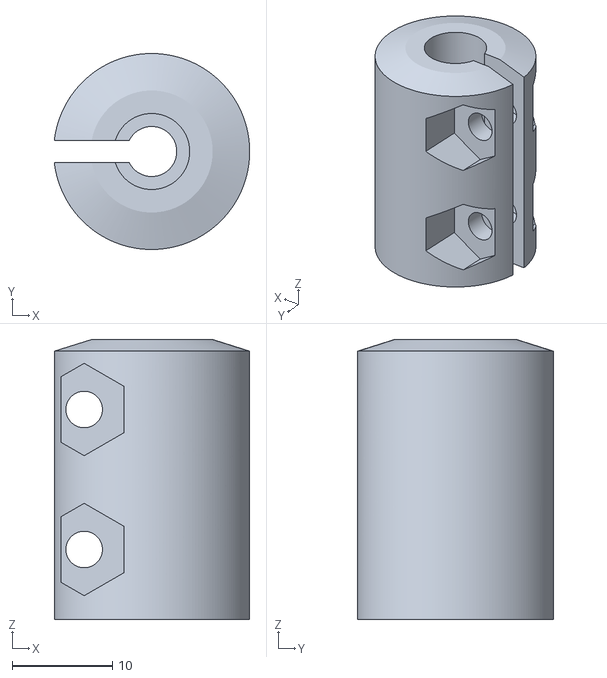
[picture p67: CAD file, 2019-04-01]
Stock Parts/Rigid_Coupler_5_16_to_5mm.STL
19.5 x 19.6 x 28.0
