loidolt/mostly-printed-cnc/(list of files, cad)

Other CAD files:
Calibration/heptagon-circle-50mm.dxf
ModParts/EMT_Conduit_Caps/emtcapwiresendv2.STL
ModParts/Ramps14SmartLCD/minion_lcd_back_remix_1.0.stl
ModParts/EMT_Conduit_Caps/emtcapwiresv2.STL
ModParts/Feet/Flex_Foot.STL
ModParts/RAMPs 1.4 Case/Right_side_reset_fixed.stl
ModParts/Electronics Case/standoff.skp
ModParts/Modular Electronics Case/Designed/powerSwitchPanel.skp
Stock Parts/Tool_Holder_Nut_Trap.STL
Stock Parts/z_nut_lock.STL
Stock Parts/z_nut_lock_11mm_coupler.STL
