loidolt/mostly-printed-cnc/Documentation/MP_CNC_PrintData_v02.pdf

9/4/2015 | MP_CNC_PrintData_v02
https://docs.google.com/spreadsheets/d/1ULWcQ0fmXPxbvGMUKqsk_nRjMc4W53P2SblkcSQOP8/pubhtml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 | 1/1

MP_CNC_PrintData_v02 : Sheet1

Published by Google Sheets (https://docs.google.com/spreadsheets/?authuser=0&usp=sheets_web) – Report Abuse (https://docs.google.com/abuse?id=1ULWcQ0fmXPx-bvGMUKqsk_nRjMc4W53P2SblkcSQOP8) – Updated automatically every 5 minutes

Bearing Parts
4 | Roller_F | 5:27:07 | 21:48:28 | 3.97 | 15.88 | 106.28 | 425.12
4 | Middle_Z | 1:38:54 | 6:35:36 | 1.02 | 4.08 | 25.56 | 102.24
2 | Middle_Joiner | 3:45:46 | 7:31:32 | 2.26 | 4.52 | 57.76 | 115.52
2 | Middle_End | 2:55:04 | 5:50:08 | 2.07 | 4.14 | 52.51 | 105.02
| Total for Bearing Parts | | 41:45:44 | | 28.62 | | 747.90
| Non Bearing Pats
4 | Corner_Block_Lock | 1:12:03 | 4:48:12 | 0.43 | 1.72 | 12.86 | 51.44
4 | Corner_Block | 3:50:25 | 15:21:40 | 2.43 | 9.72 | 91.05 | 364.2
2 | 2x Roller_Lock | 2:02:43 | 4:05:26 | 1.18 | 2.36 | 40.2 | 80.4
4 | Roller_Motor_Mount Original | | | | | 27.68 | 110.72
4 | | 1:27:38 | 5:50:32 | 0.91 | 3.64
1 | Z_Motor_Mount_10mm_Longer | 3:37:13 | 3:37:13 | 1.29 | 1.29 | 40.63 | 40.63
1 | Z_Nut_lock | 1:56:42 | 1:56:42 | 0.41 | 0.41 | 11 | 11
1 | Tool_Holder_13mm 2x | 3:28:46 | 3:28:46 | 1.34 | 1.34 | 40.94 | 40.94
1 | 2x Tool_Holder_Nut_Trap | 1:10:57 | 1:10:57 | 0.74 | 0.74 | 25.52 | 25.52
1 | Rigid_Coupler_5_16_to_5mm | 1:10:27 | 1:10:27 | 0.21 | 0.21 | 6.25 | 6.25
| Total for Non Bearing Parts | | 17:29:55 | | 21.43 | | 731.10
| Extras
1 | Z Knob | 0:24:12 | 0:24:12 | 0.12 | 0.12 | 3.76 | 3.76
8 | Flex_Foot | 2:29:04 | 19:52:32 | 1.18 | 9.44 | 36.89 | 295.12
2 | Left Mechanical Belt tightener | 3:37:43 | 7:15:26 | 1.26 | 2.52 | 35.54 | 71.08
2 | Right Mechanical Belt Tightener | 3:40:52 | 7:21:44 | 1.25 | 2.5 | 34.54 | 69.08
| Total for Extra Parts | | 34:53:54 | | 14.58 | | 439.04
| Total for all Parts | | 118:09:33 | | 64.63 | | 1918.04
Qty | Print Time | Total Times | Weight | Total Weights in Ounces | Volume in cm3 | Total Volume in cm3

Qty

Roller_Motor_MountWithWireCovers

Qty
